TAN-ASH/Relay-Board-2.0/(list of files, cad)

Other CAD files:
Gerber_Relay_Board_2.0_Rev_1.0.0/Relay Board 2.0-B_SilkS.dxf
