TAN-ASH/Relay-Board-2.0/Relay Board 2.0.pdf

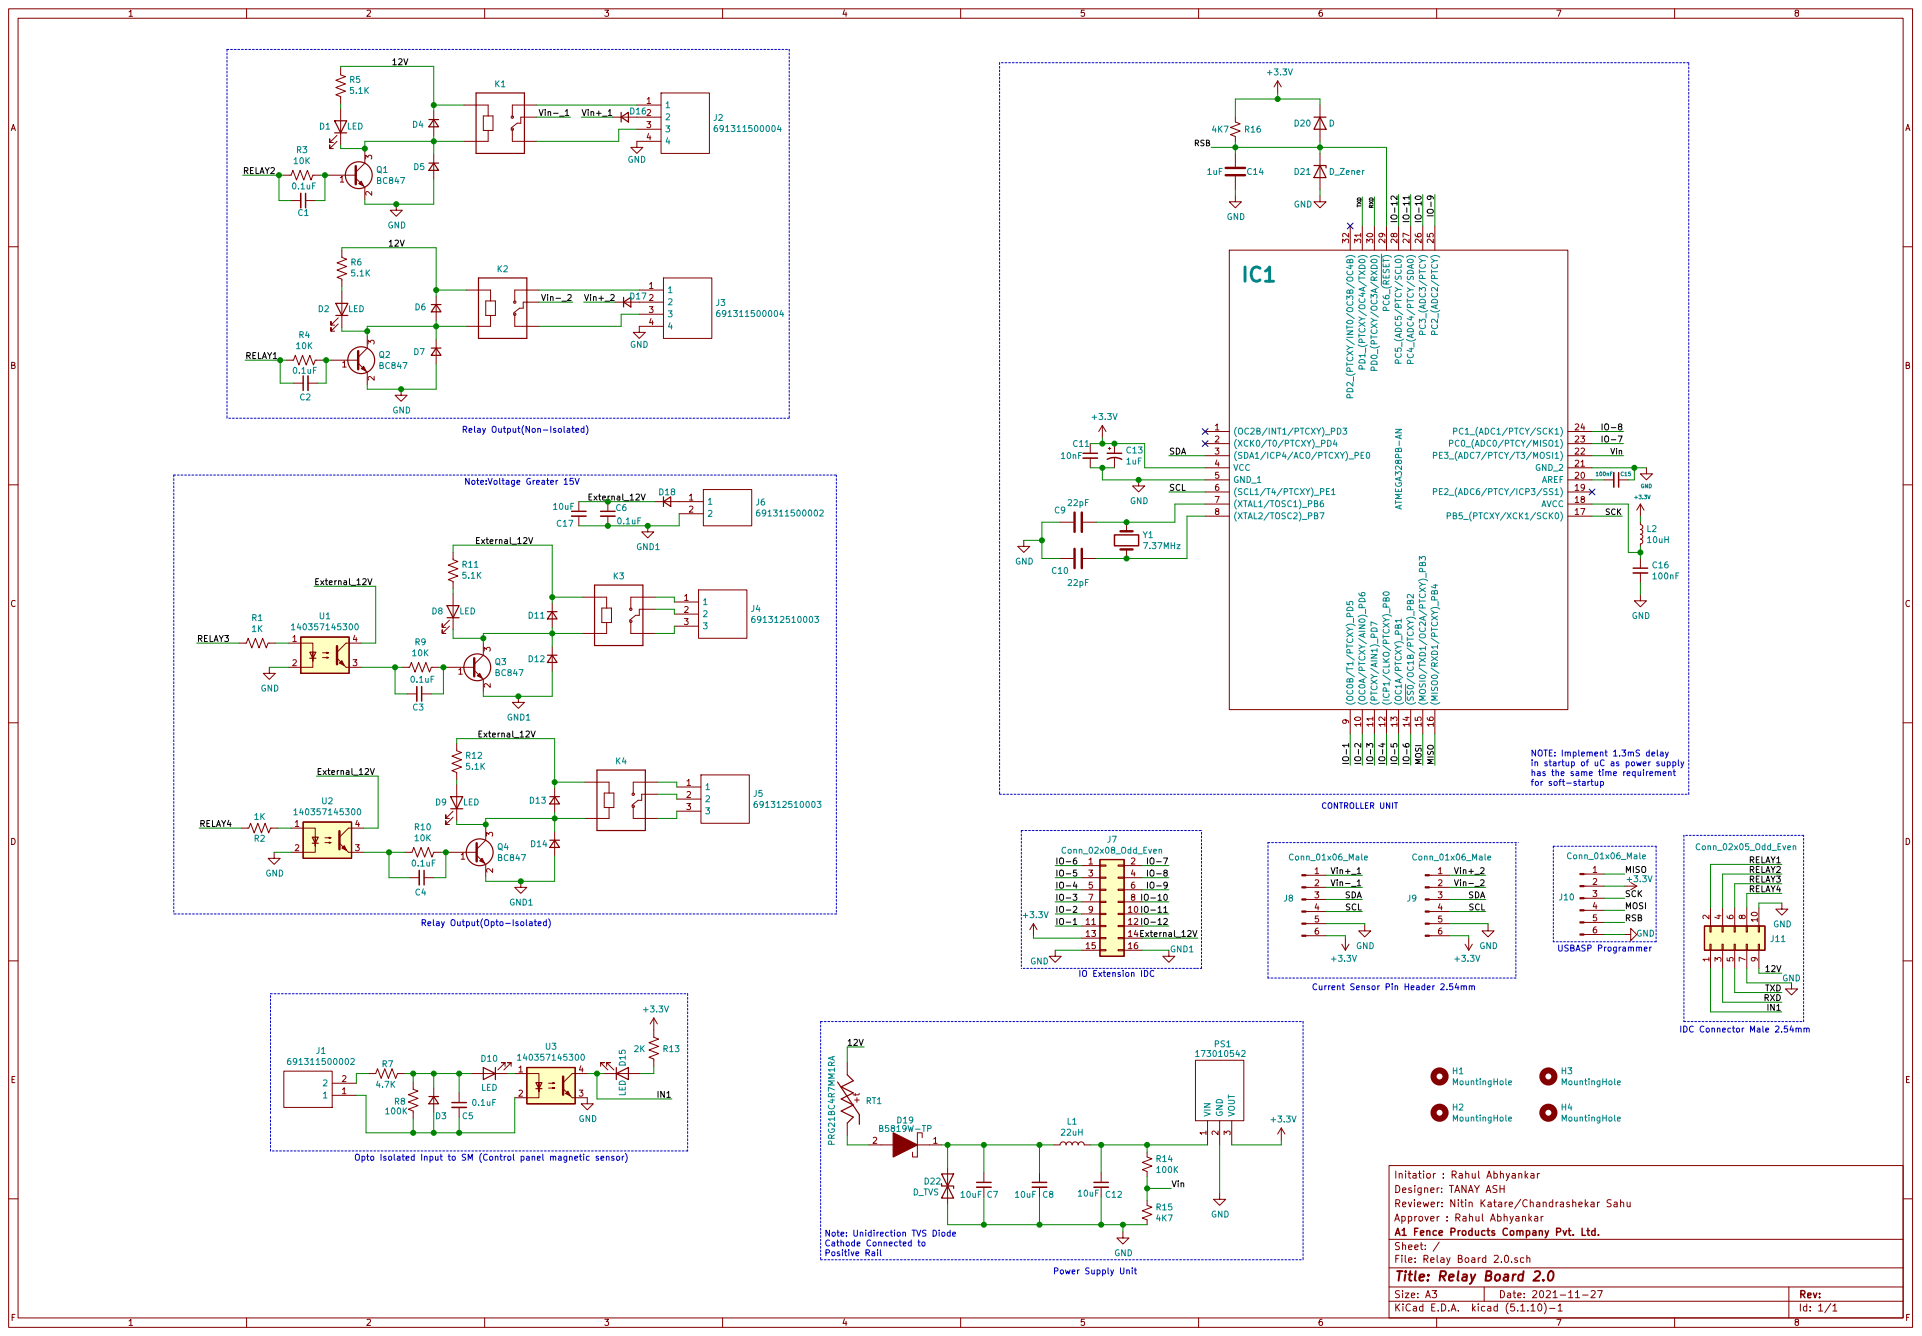
[picture p1: page 1]

Relay Output(Non-Isolated)

9 (OC0A/PTCXY/AIN0)_PD6 10 (PTCXY/AIN1)_PD7 11 (ICP1/CLKO/PTCXY)_PB0 12 (OC1A/PTCXY)_PB1 13 (SS0/OC1B/PTCXY)_PB2 14 (MOSI0/TXD1/OC2A/PTCXY)_PB3 15 (MISO0/RXD1/PTCXY)_PB4 16

NOTE: Implement 1.3mS delay
in startup of uC as power supply
has the same time requirement
for soft-startup

Note: Unidirection TVS Diode Cathode Connected to Positive Rail Relay Output(Opto-Isolated)

IO Extension IDC Opto Isolated Input to SM (Control panel magnetic sensor)

Approver : Rahul Abhyankar Reviewer: Nitin Katare/Chandrashekar Sahu Designer: TANAY ASH

File: Relay Board 2.0.sch Sheet: / A1 Fence Products Company Pvt. Ltd.

Id: 1/1 Title: Relay Board 2.0
