TAN-ASH/Relay-Board-2.0/Relay Board 2.0.kicad_pcb

## KiCad design Relay Board 2.0.kicad_pcb (2021-12-04)

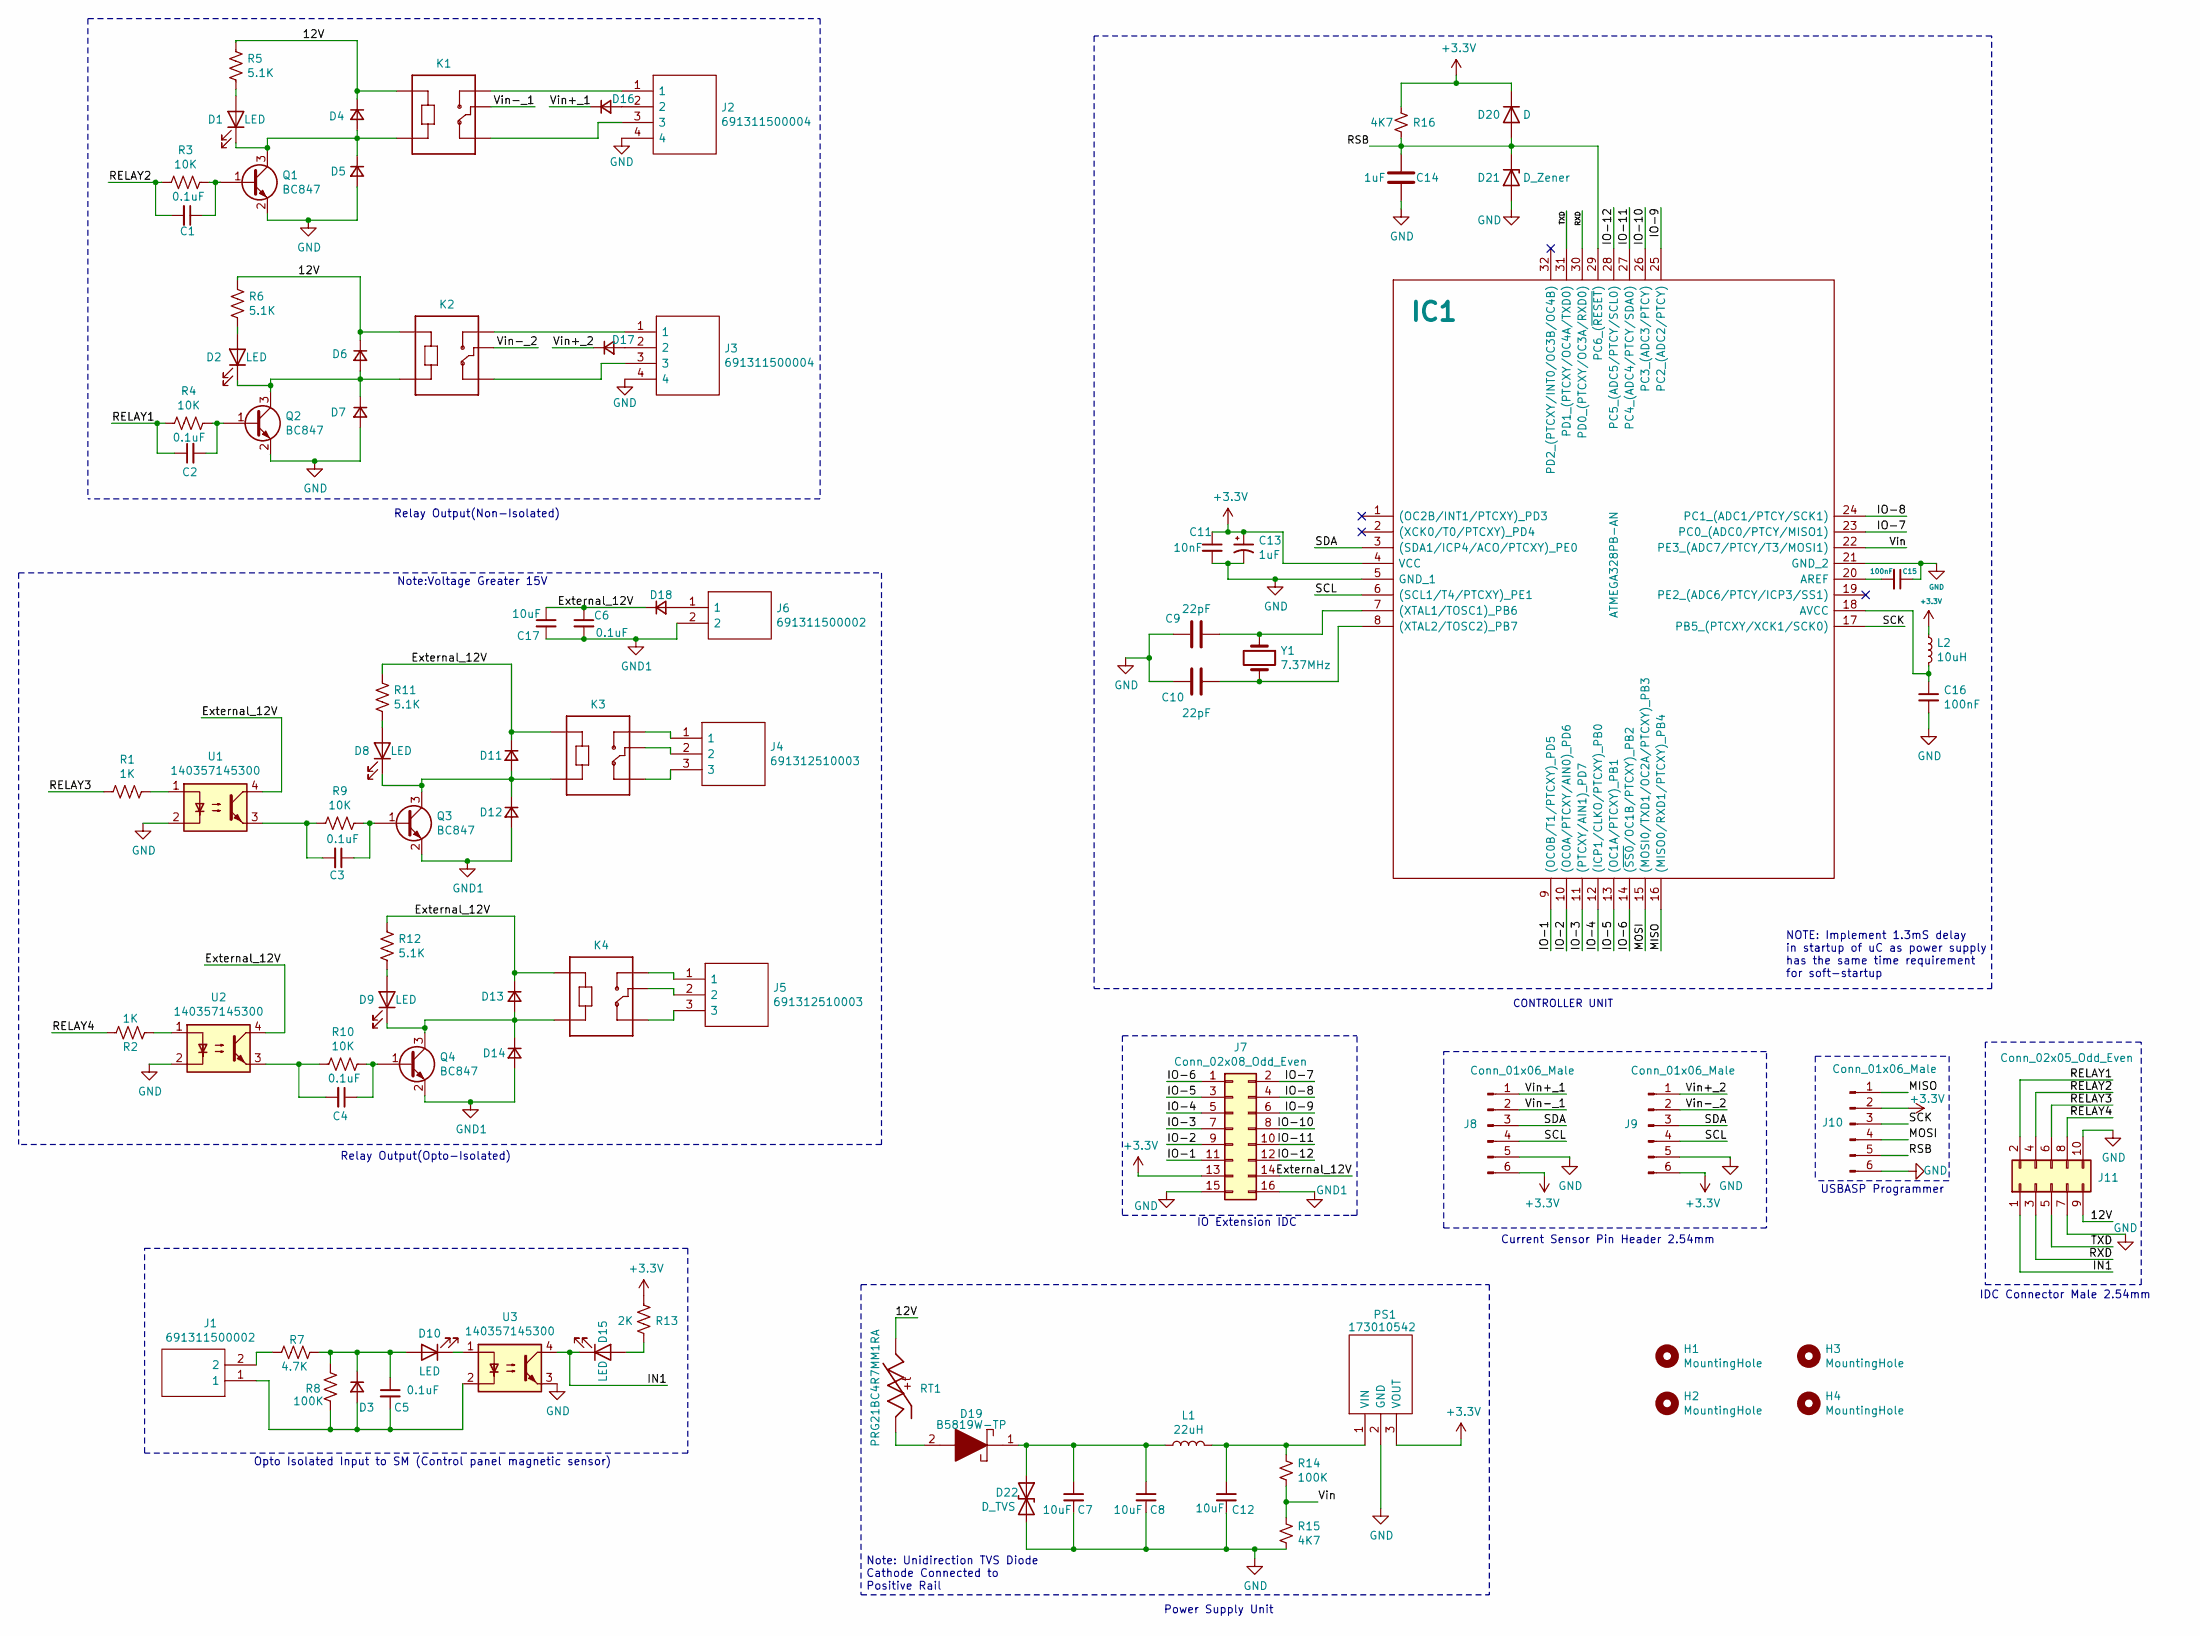
[picture p2: schematic Relay Board 2.0.sch, Relay Board 2.0]

Parts:
C1, C2, C3, C4, C5, C6: 0.1uF; C_0603_1608Metric
C7, C8, C12: 10uF; C_0805_2012Metric
C9, C10: 22pF; C_0603_1608Metric
C11: 10nF; C_0603_1608Metric
C13: 1uF; C_1206_3216Metric
C14: 1uF; C_0603_1608Metric
C15, C16: 100nF; C_0603_1608Metric
C17: 10uF; CP_EIA-3528-12_Kemet-T
D1, D2, D8, D9, D10, D15: LED; LED_0805_2012Metric
D3, D4, D5, D6, D7, D11, D12, D13, D14: D_Small; FDLL4448
D16, D17, D18: D_Small; SOD3716X135N
D19: B5819W-TP; SOD3716X135N; Manufacturer_Part_Number B5819W-TP; Mouser Part Number 833-B5819W-TP
D20: D; FDLL4448
D21: D_Zener; SOD3716X145N
D22: D_TVS; D_SOD-123
H1, H2, H3, H4: MountingHole; MountingHole_2.2mm_M2_ISO7380_Pad
IC1: ATMEGA328PB-AN; QFP80P900X900X120-32N; Manufacturer_Part_Number ATMEGA328PB-AN; Mouser Part Number 556-ATMEGA328PB-AN
J1, J6: 691311500002; Manufacturer_Part_Number 691311500002; Mouser Part Number 710-691311500002
J2, J3: 691311500004; Manufacturer_Part_Number 691311500004; Mouser Part Number 710-691311500004
J4, J5: 691312510003; 691311500003; Manufacturer_Part_Number 691312510003; Mouser Part Number 710-691312510003
J7: Conn_02x08_Odd_Even; IDC-Header_2x08_P2.54mm_Vertical
J8, J9, J10: Conn_01x06_Male; PinHeader_1x06_P2.54mm_Vertical
J11: Conn_02x05_Odd_Even; IDC-Header_2x05_P2.54mm_Vertical
K1, K2, K3, K4: SRD-05VDC-SL-C; RELAY_SRD-05VDC-SL-C
L1: 22uH; WE-PD2_5848_582055
L2: 10uH; L_1206_3216Metric
PS1: 173010542; Manufacturer_Part_Number 173010542; Mouser Part Number 710-173010542
Q1, Q2, Q3, Q4: BC847; SOT-23
R1, R2: 1K; R_0603_1608Metric
R3, R4, R9, R10: 10K; R_0603_1608Metric
R5, R6, R11, R12: 5.1K; R_0603_1608Metric
R7: 4.7K; R_0603_1608Metric
R8, R14: 100K; R_0603_1608Metric
R13: 2K; R_0603_1608Metric
R15, R16: 4K7; R_0603_1608Metric
RT1: PRG21BC4R7MM1RA; THRMC2012X110N; PARTREV N/A
U1, U2, U3: 140357145300; SOP254P700X210-4N
Y1: 7.37MHz; ABLS373728MHZD4YT

Connections:
+3V3: C11.1, C13.1, D20.1 (K), IC1.4 (VCC), J7.13, J8.6, J9.6, J10.2, L2.1, PS1.3 (VOUT), R13.2, R16.1
/12V: D4.1 (K), D6.1 (K), J11.9, K1.A1, K2.A1, R5.2, R6.2, RT1.2
/External_12V: C6.1, C17.1, D11.1 (K), D13.1 (K), D18.1 (K), J7.14, K3.A1, K4.A1, R11.2, R12.2, U1.4, U2.4
/IN1: D15.1 (K), J11.1, U3.4
/IO-1: IC1.9 ((OC0B/T1/PTCXY)_PD5), J7.11
/IO-2: IC1.10 ((OC0A/PTCXY/AIN0)_PD6), J7.9
/IO-3: IC1.11 ((PTCXY/AIN1)_PD7), J7.7
/IO-4: IC1.12 ((ICP1/CLKO/PTCXY)_PB0), J7.5
/IO-5: IC1.13 ((OC1A/PTCXY)_PB1), J7.3
/IO-6: IC1.14 ((~SS0~/OC1B/PTCXY)_PB2), J7.1
/IO-7: IC1.23 (PC0_(ADC0/PTCY/MISO1)), J7.2
/IO-8: IC1.24 (PC1_(ADC1/PTCY/SCK1)), J7.4
/IO-9: IC1.25 (PC2_(ADC2/PTCY)), J7.6
/IO-10: IC1.26 (PC3_(ADC3/PTCY)), J7.8
/IO-11: IC1.27 (PC4_(ADC4/PTCY/SDA0)), J7.10
/IO-12: IC1.28 (PC5_(ADC5/PTCY/SCL0)), J7.12
/MISO: IC1.16 ((MISO0/RXD1/PTCXY)_PB4), J10.1
/MOSI: IC1.15 ((MOSI0/TXD1/OC2A/PTCXY)_PB3), J10.4
/RELAY1: C2.1, J11.2, R4.1
/RELAY2: C1.2, J11.4, R3.1
/RELAY3: J11.6, R1.1
/RELAY4: J11.8, R2.1
/RSB: C14.1, D20.2 (A), D21.1 (K), IC1.29 (PC6_(~RESET)), J10.5, R16.2
/RXD: IC1.30 (PD0_(PTCXY/OC3A/RXD0)), J11.3
/SCK: IC1.17 (PB5_(PTCXY/XCK1/SCK0)), J10.3
/SCL: IC1.6 ((SCL1/T4/PTCXY)_PE1), J8.4, J9.4
/SDA: IC1.3 ((SDA1/ICP4/ACO/PTCXY)_PE0), J8.3, J9.3
/TXD: IC1.31 (PD1_(PTCXY/OC4A/TXD0)), J11.5
/Vin: IC1.22 (PE3_(ADC7/PTCY/T3/MOSI1)), R14.2, R15.1
/Vin+_1: D16.1 (K), J8.1
/Vin+_2: D17.1 (K), J9.1
/Vin-_1: J8.2, K1.COM
/Vin-_2: J9.2, K2.COM
GND: C7.2, C8.2, C9.2, C10.2, C11.2, C12.2, C13.2, C14.2, C15.1, C16.2, D5.2 (A), D7.2 (A), D21.2 (A), D22.2 (A2), IC1.5 (GND_1), IC1.21 (GND_2), J2.4, J3.4, J7.15, J8.5, J9.5, J10.6, J11.7, J11.10, PS1.2 (GND), Q1.2 (E), Q2.2 (E), R15.2, U1.2, U2.2, U3.3
GND1: C6.2, C17.2, D12.2 (A), D14.2 (A), J6.2, J7.16, Q3.2 (E), Q4.2 (E)
unnamed: C1.1, Q1.1 (B), R3.2
unnamed: C2.2, Q2.1 (B), R4.2
unnamed: C3.1, Q3.1 (B), R9.2
unnamed: C3.2, R9.1, U1.3
unnamed: C4.1, Q4.1 (B), R10.2
unnamed: C4.2, R10.1, U2.3
unnamed: C5.1, D3.1 (K), D10.2 (A), R7.1, R8.1
unnamed: C5.2, D3.2 (A), J1.1, R8.2, U3.2
unnamed: C7.1, C8.1, D19.1, D22.1 (A1), L1.1
unnamed: C9.1, IC1.7 ((XTAL1/TOSC1)_PB6), Y1.1
unnamed: C10.1, IC1.8 ((XTAL2/TOSC2)_PB7), Y1.2
unnamed: C12.1, L1.2, PS1.1 (VIN), R14.1
unnamed: C15.2, IC1.20 (AREF)
unnamed: C16.1, IC1.18 (AVCC), L2.2
unnamed: D1.1 (K), D4.2 (A), D5.1 (K), K1.A2, Q1.3 (C)
unnamed: D1.2 (A), R5.1
unnamed: D2.1 (K), D6.2 (A), D7.1 (K), K2.A2, Q2.3 (C)
unnamed: D2.2 (A), R6.1
unnamed: D8.2 (A), R11.1
unnamed: D9.2 (A), R12.1
unnamed: D10.1 (K), U3.1
unnamed: D8.1 (K), D11.2 (A), D12.1 (K), K3.A2, Q3.3 (C)
unnamed: D9.1 (K), D13.2 (A), D14.1 (K), K4.A2, Q4.3 (C)
unnamed: D15.2 (A), R13.1
unnamed: D16.2 (A), J2.2
unnamed: D17.2 (A), J3.2
unnamed: D18.2 (A), J6.1
unnamed: D19.2, RT1.1
unnamed: J1.2, R7.2
unnamed: J2.1, K1.NO
unnamed: J2.3, K1.NC
unnamed: J3.1, K2.NO
unnamed: J3.3, K2.NC
unnamed: J4.1, K3.NO
unnamed: J4.2, K3.COM
unnamed: J4.3, K3.NC
unnamed: J5.1, K4.NO
unnamed: J5.2, K4.COM
unnamed: J5.3, K4.NC
unnamed: R1.2, U1.1
unnamed: R2.2, U2.1

Notes on the sheet:
CONTROLLER UNIT
USBASP Programmer
IDC Connector Male 2.54mm
Power Supply Unit
Current Sensor Pin Header 2.54mm
Relay Output(Opto-Isolated)
Relay Output(Non-Isolated)
IO Extension IDC
Opto Isolated Input to SM (Control panel magnetic sensor)
NOTE: Implement 1.3mS delay in startup of uC as power supply has the same time requirement for soft-startup
Note:Voltage Greater 15V
Note: Unidirection TVS Diode Cathode Connected to Positive Rail

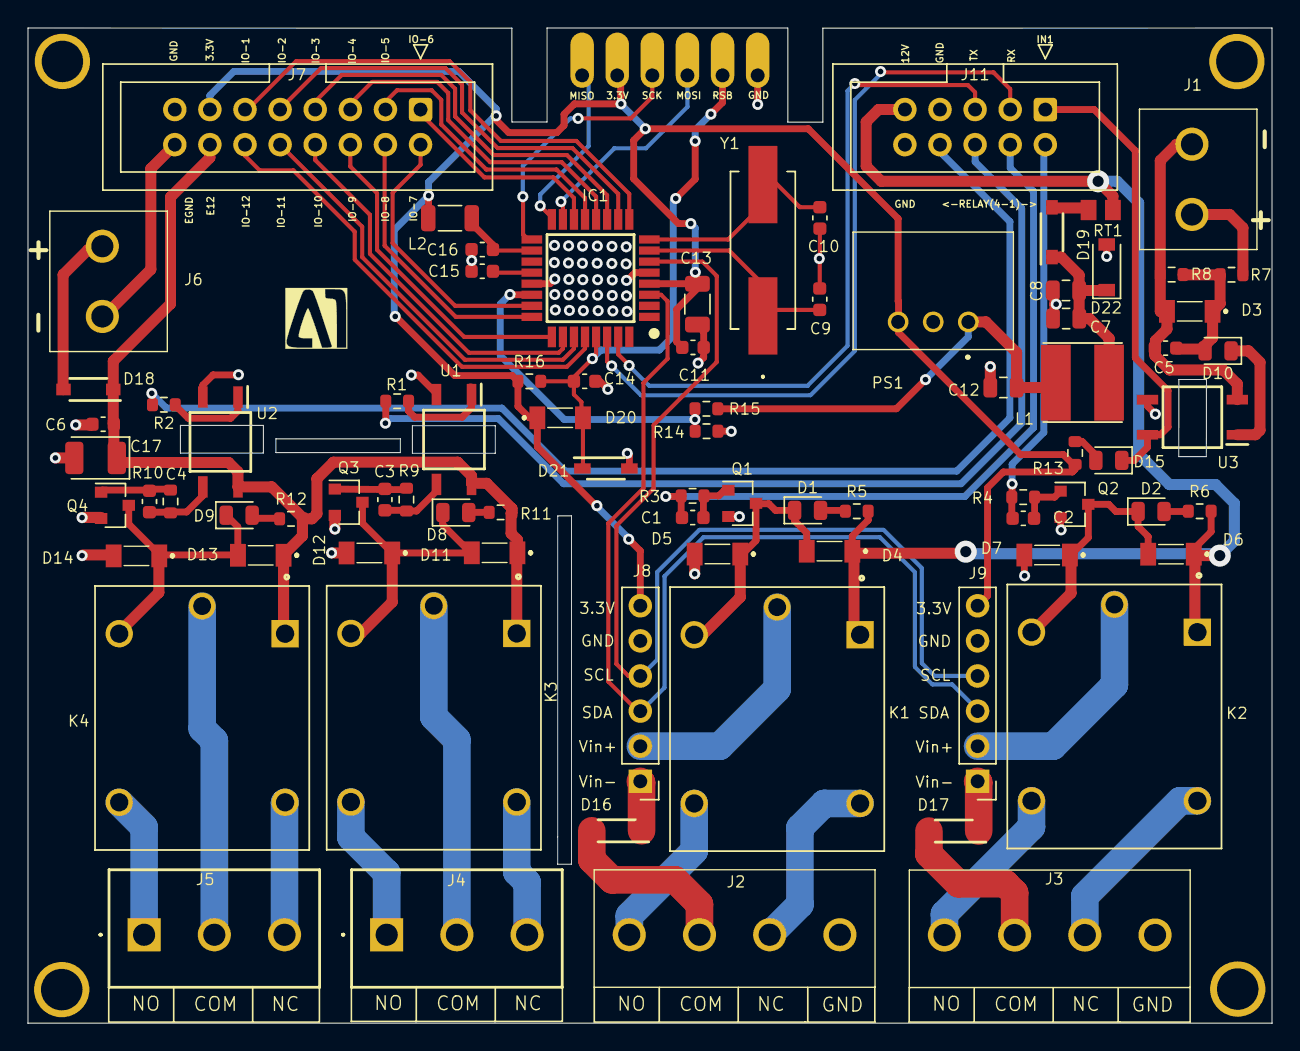
[picture p3: board Relay Board 2.0.kicad_pcb from above]

Board: 2 copper layers, 90.0 x 72.0 mm, 87 parts (0 on the bottom side), 76 nets.
